antonloof/attiny10prog/kicad/attiny10dev.kicad_pcb

## KiCad design kicad/attiny10dev.kicad_pcb (2021-03-03)

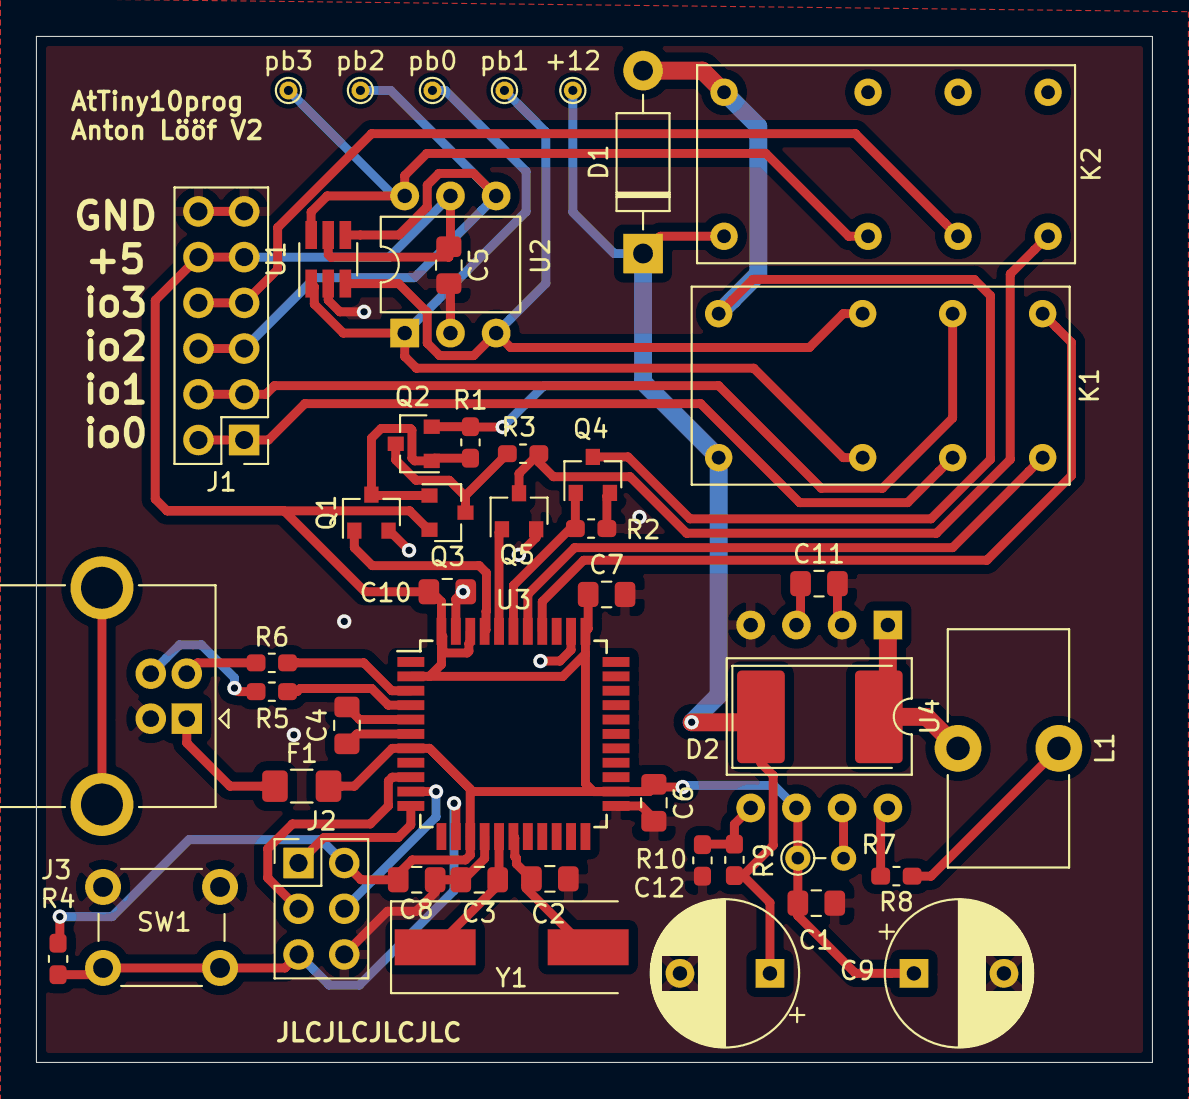
[picture p1: board attiny10dev.kicad_pcb from above]

Board: 2 copper layers, 62.0 x 57.0 mm, 47 parts (0 on the bottom side), 37 nets.

Parts:
+12: TestPoint; TestPoint_THTPad_D1.0mm_Drill0.5mm
C1, C5, C6, C7, C8, C10: 100n; C_0805_2012Metric_Pad1.15x1.40mm_HandSolder
C2, C3: 22p; C_0805_2012Metric_Pad1.15x1.40mm_HandSolder
C4: 1u; C_0805_2012Metric_Pad1.15x1.40mm_HandSolder
C9, C12: 470u; CP_Radial_D8.0mm_P5.00mm
C11: 500p; C_0805_2012Metric_Pad1.15x1.40mm_HandSolder
D1: D; D_DO-41_SOD81_P10.16mm_Horizontal
D2: D; D_3220_8050Metric_Pad2.65x5.15mm_HandSolder
F1: 500ma; Fuse_1206_3216Metric_Pad1.42x1.75mm_HandSolder
J1: Conn_02x06_Odd_Even; PinHeader_2x06_P2.54mm_Vertical
J2: Conn_02x03_Odd_Even; PinHeader_2x03_P2.54mm_Vertical
J3: USB_B; USB_B_OST_USB-B1HSxx_Horizontal
K1, K2: m4-12h
L1: 33u; L_Toroid_Vertical_L13.0mm_W6.5mm_P5.60mm
Q1, Q3, Q4, Q5: 2N7002; SOT-23
Q2: BSS84; SOT-23
R1, R2, R3, R4, R10: 10k; C_0603_1608Metric_Pad1.05x0.95mm_HandSolder
R5, R6: 22; C_0603_1608Metric_Pad1.05x0.95mm_HandSolder
R7: 470m; R_Axial_DIN0204_L3.6mm_D1.6mm_P2.54mm_Vertical
R8: 180; C_0603_1608Metric_Pad1.05x0.95mm_HandSolder
R9: 86k; C_0603_1608Metric_Pad1.05x0.95mm_HandSolder
SW1: SW_Push; SW_PUSH_6mm
U1: ATtiny10-TS; SOT-23-6_Handsoldering
U2: ATtiny10-TS; DIP-6_W7.62mm
U3: ATmega32U4-AU; TQFP-44_10x10mm_P0.8mm
U4: MC34063AD; DIP-8_W10.16mm
Y1: 16Mhz; Crystal_SMD_HC49-SD
pb0, pb1, pb2, pb3: TestPoint; TestPoint_THTPad_D1.0mm_Drill0.5mm

Connections:
+5V: C1.1, C5.1, C6.1, C7.1, C8.1, C9.1, C10.1, F1.2, J1.9, J1.10, J2.2, Q3.2, R4.1, R7.1, U1.5, U2.5, U3.2, U3.7, U3.14, U3.24, U3.34, U3.42, U3.44, U4.6
+12V: +12.1, C12.1, D1.1, D2.1, K1.1, K2.1, Q2.2, R1.1, R9.1
/hard_reset: Q1.1, U3.41
/io0: J1.1, J1.2, K1.4
/io1: J1.3, J1.4, K1.7
/io2: J1.5, J1.6, U1.4, U2.4, pb2.1
/io3: J1.7, J1.8, K2.4
/lower_relay: D1.2, K1.10, K2.10, Q4.3
/pb0: K1.3, U1.1, U2.1, pb0.1
/pb1: K1.8, U1.3, U2.3, pb1.1
/pb3: K2.3, U1.6, U2.6, pb3.1
/prog: Q4.1, R2.1, U3.39
/prog_miso: J2.1, U3.11
/prog_mosi: J2.4, U3.10
/prog_rst: J2.5, R4.2, SW1.2, U3.13
/prog_sck: J2.3, U3.9
/reset_low: Q5.1, U3.40
/tpi_clk: K1.6, U3.37
/tpi_data: K1.5, U3.38
GND: C1.2, C2.2, C3.2, C4.2, C5.2, C6.2, C7.2, C8.2, C9.2, C10.2, C11.2, C12.2, J1.11, J1.12, J2.6, J3.4, Q1.2, Q4.2, Q5.2, R2.2, R10.2, SW1.1, U1.2, U2.2, U3.5, U3.15, U3.23, U3.35, U3.43, U4.2, U4.4
unnamed: C2.1, U3.17, Y1.2
unnamed: C3.1, U3.16, Y1.1
unnamed: C4.1, U3.6
unnamed: C11.1, U4.3
unnamed: D2.2, L1.2, U4.1
unnamed: F1.1, J3.1
unnamed: J3.2, R6.1
unnamed: J3.3, R5.1
unnamed: K2.5, Q5.3, R3.1
unnamed: L1.1, R8.1
unnamed: Q1.3, Q2.1, Q3.1, R1.2
unnamed: Q2.3, Q3.3, R3.2
unnamed: R5.2, U3.4
unnamed: R6.2, U3.3
unnamed: R7.2, U4.7
unnamed: R8.2, U4.8
unnamed: R9.2, R10.1, U4.5
