antonloof/attiny10prog/(commit log)

2021-02-21 Create V2 of shematic
    with integrated boost and uC
    [attiny10dev.sch]
2021-02-26 Add 12v reset
2021-02-28 Add 12v reset to script and properly to prog
    [attiny10prog.ino, programmer.py]
2021-02-28 Work on next gen pcb
    [attiny10dev.kicad_pcb, attiny10dev.sch]
2021-03-01 V2 of pcb
    [attiny10dev.kicad_pcb, attiny10dev.sch]
2021-03-02 Finalize rev 2 pcb
    [attiny10dev.kicad_pcb, attiny10dev.sch]
2021-03-03 add jlc order no marker
    [attiny10dev.kicad_pcb]
2021-04-19 Fix boost
    [attiny10dev.sch]
2021-04-21 Use correct ports, send 2 bytes at all times
    [attiny10prog.ino, programmer.py]
